axlynrocks/snap/README.md

# snap!

snap is a camera/tracker thing designed for logging your adventures! (readme still in progress)
