axlynrocks/snap/components/DF12NB(3.0)-36DP-0.5V(51).stp

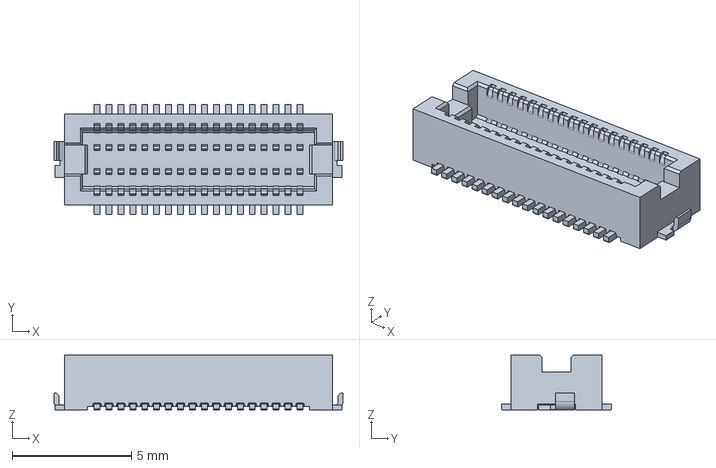
[picture p6: CAD file, 2026-09-12]
components/DF12NB(3.0)-36DP-0.5V(51).stp
12.1 x 4.60 x 2.30 mm
