axlynrocks/snap/components/DF12NB(3.0)-36DS-0.5V(51).stp

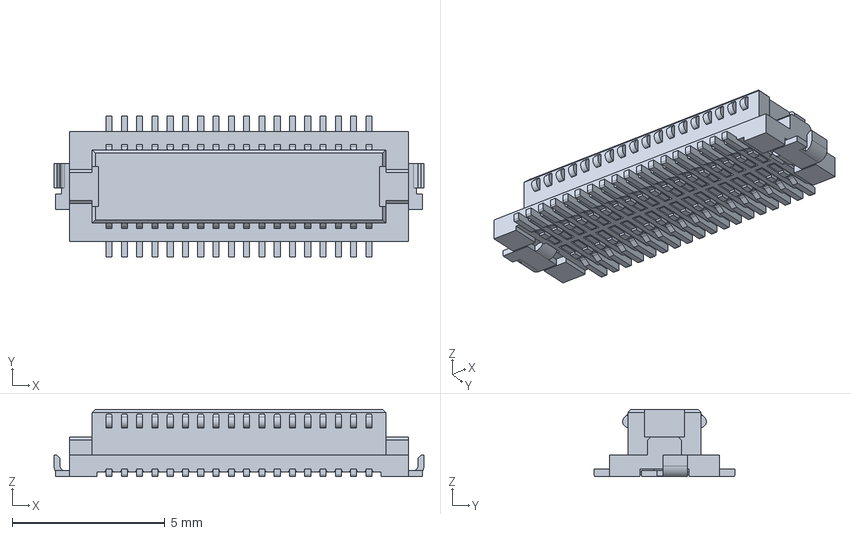
[picture p7: CAD file, 2026-09-12]
components/DF12NB(3.0)-36DS-0.5V(51).stp
12.1 x 4.60 x 2.20 mm
