axlynrocks/snap/components/BG95.step

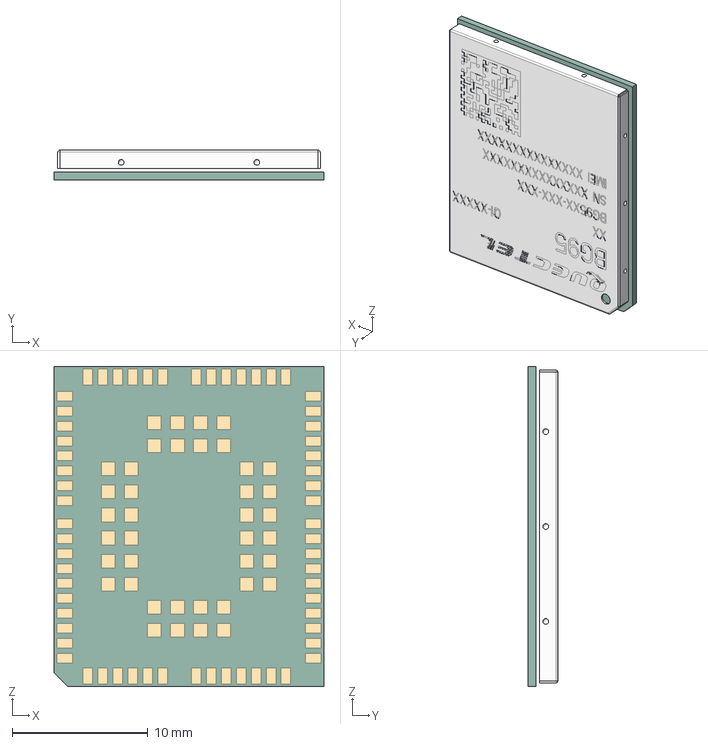
[picture p8: CAD file, 2026-09-10]
components/BG95.step
19.9 x 2.20 x 23.6 mm
BG95_COVER
BG95_PCB
