axlynrocks/snap/components/EG912U-GL.step

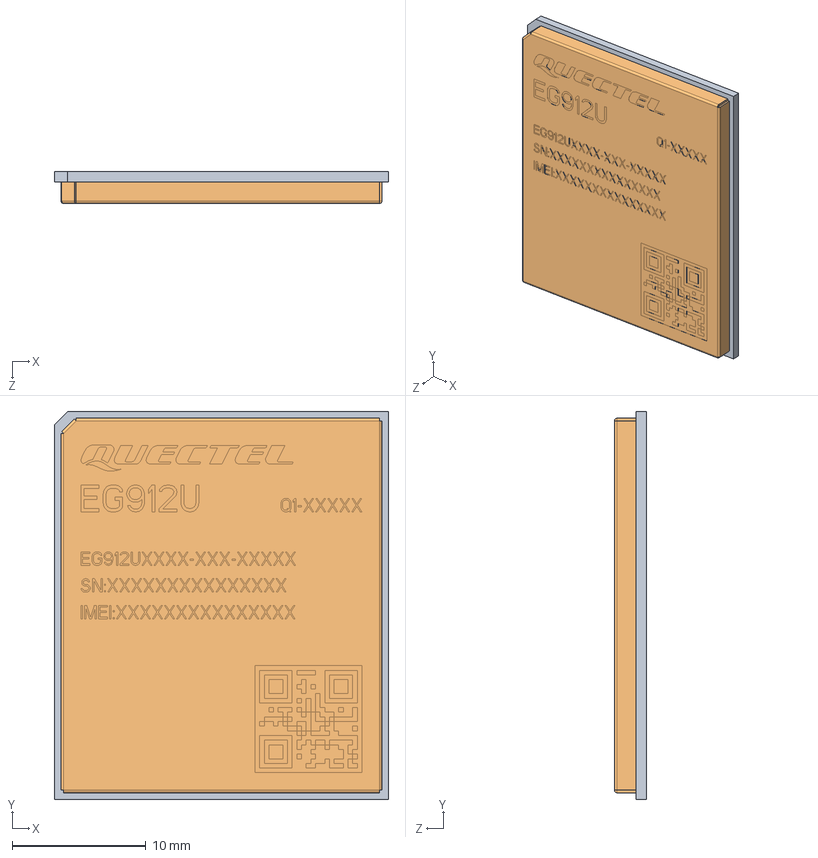
[picture p9: CAD file, 2026-09-01]
components/EG912U-GL.step
25.0 x 29.0 x 2.40 mm
EG912N-EN_PCB.stp
EG912N-EU.stp
