axlynrocks/snap/snap.ioc

Mcu.UserName=STM32H7B3VITx
PA0.GPIO_Label=T_TX
PA0.Signal=UART4_TX
PA1.Signal=OCTOSPIM_P1_IO3
PA10.GPIO_Label=RGB_LED_B
PA10.Signal=GPIO_Output
PA11.GPIO_Label=MIC_WS
PA11.Signal=I2S2_WS
PA12.GPIO_Label=MIC_CK
PA12.Signal=I2S2_CK
PA13.GPIO_Label=T_SWDIO
PA13.Signal=DEBUG_JTMS-SWDIO
PA14.GPIO_Label=T_SWCLK
PA14.Signal=DEBUG_JTCK-SWCLK
PA15.GPIO_Label=T_JTDI
PA15.Signal=DEBUG_JTDI
PA3.Signal=OCTOSPIM_P1_CLK
PA4.Signal=DCMI_HSYNC
PA6.Signal=DCMI_PIXCLK
PA7.Signal=OCTOSPIM_P1_IO2
PA8.GPIO_Label=RGB_LED_R
PA8.Signal=GPIO_Output
PA9.GPIO_Label=RGB_LED_G
PA9.Signal=GPIO_Output
PB0.Signal=OCTOSPIM_P1_IO1
PB10.Signal=OCTOSPIM_P1_NCS
PB12.GPIO_Label=RF_S_RX
PB12.Signal=UART5_RX
PB13.GPIO_Label=RF_S_TX
PB13.Signal=UART5_TX
PB3.GPIO_Label=T_SWO
PB3.Signal=DEBUG_JTDO-SWO
PB4.GPIO_Label=T_NRST
PB4.Signal=DEBUG_NJTRST
PB6.GPIO_Label=DCMI_SCL
PB6.Signal=I2C1_SCL
PB7.Signal=DCMI_VSYNC
PB9.GPIO_Label=DCMI_SDA
PB9.Signal=I2C1_SDA
PC10.Signal=SDMMC1_D2
PC11.Signal=SDMMC1_D3
PC12.Signal=SDMMC1_CK
PC14-OSC32_IN.Signal=RCC_OSC32_IN
PC15-OSC32_OUT.Signal=RCC_OSC32_OUT
PC2_C.GPIO_Label=MIC_SDI
PC2_C.Signal=I2S2_SDI
PC3_C.Signal=OCTOSPIM_P1_IO0
PC6.Signal=DCMI_D0
PC7.Signal=DCMI_D1
PC8.Signal=SDMMC1_D0
PC9.Signal=SDMMC1_D1
PD0.GPIO_Label=T_RX
PD0.Signal=UART4_RX
PD10.GPIO_Label=RF_GPIO_08
PD10.Signal=GPIO_Output
PD11.GPIO_Label=RF_GPIO_06
PD11.Signal=GPIO_Output
PD12.GPIO_Label=RF_GPIO_04
PD12.Signal=GPIO_Output
PD13.GPIO_Label=RF_GPIO_03
PD13.Signal=GPIO_Output
PD14.GPIO_Label=RF_GPIO_02
PD14.Signal=GPIO_Input
PD15.GPIO_Label=RF_GPIO_01
PD15.Signal=GPIO_Output
PD2.Signal=SDMMC1_CMD
PD3.Signal=DCMI_D5
PD4.GPIO_Label=DCMI_RST
PD4.Signal=GPIO_Output
PD5.GPIO_Label=DCMI_FSIN
PD5.Signal=GPIO_Output
PD6.GPIO_Label=DCMI_PWDN
PD6.Signal=GPIO_Output
PD8.GPIO_Label=RF_GPIO_10
PD8.Signal=GPIO_Output
PD9.GPIO_Label=RF_GPIO_09
PD9.Signal=GPIO_Output
PE0.Signal=DCMI_D2
PE1.Signal=DCMI_D3
PE10.GPIO_Label=RF_CTS
PE10.Signal=UART7_CTS
PE11.GPIO_Label=DCMI_NSS
PE11.Signal=SPI4_NSS
PE13.GPIO_Label=DCMI_MISO
PE13.Signal=SPI4_MISO
PE14.GPIO_Label=DCMI_MOSI
PE14.Signal=SPI4_MOSI
PE2.GPIO_Label=DCMI_SCK
PE2.Signal=SPI4_SCK
PE4.Signal=DCMI_D4
PE5.Signal=DCMI_D6
PE6.Signal=DCMI_D7
PE7.GPIO_Label=RF_RXD
PE7.Signal=UART7_RX
PE8.GPIO_Label=RF_TXD
PE8.Signal=UART7_TX
PE9.GPIO_Label=RF_RTS
PE9.Signal=UART7_RTS
PH0-OSC_IN.Signal=RCC_OSC_IN
PH1-OSC_OUT.Signal=RCC_OSC_OUT
