axlynrocks/snap/(commit log)

2026-08-21 added necessary files
    [snap.kicad_pcb, snap.kicad_sch]
2026-08-22 updated JOURNAL.md
    [snap.kicad_sch]
2026-08-23 added MCU ECAD models
    [LQFP64_STM.step]
2026-08-23 fixed symbol and footprint library paths
2026-08-23 fixed footprint library path
2026-08-23 added oscillator ECAD models
    [ECS-80-18-23B-JTN-TR.step, XTAL_SC32S-7PF20PPM_EPS.step]
2026-08-23 worked on the schematics pt.1 and researched
    [snap.kicad_sch]
2026-08-29 researched cameras and stuff
2026-08-31 removed the STM32U3C5RIT6 ECAD models
    [LQFP64_STM.step]
2026-08-31 fixed BOM and researched new MCU
2026-09-01 removed donwloaded ECAD models
    [ECS-80-18-23B-JTN-TR.step, XTAL_SC32S-7PF20PPM_EPS.step]
2026-09-01 removed outdated schematics
    [snap.kicad_sch]
2026-09-01 added EG912U-GL ECAD models to components
    [EG912U-GL.step]
2026-09-01 added antenna ECAD models to components
2026-09-01 added microphone ECAD schematic to components
2026-09-02 added microphone ECAD footprint to components
2026-09-02 added oscillator ECAD footprints to components
2026-09-02 added debug connector ECAD footprint to components
2026-09-03 actually starting to do the schematics with all these new parts
2026-09-03 added decoupling capacitors to schematic
    [snap.kicad_sch]
2026-09-03 actually starting to do the schematics pt.2
2026-09-04 actually starting to do the schematics pt.3
    [snap.kicad_sch]
2026-09-05 added button ECAD footprint to components and updated library link
2026-09-05 actually starting to do the schematics pt.4
    [snap.kicad_sch]
2026-09-06 actually starting to do the schematics pt.5
    [snap.kicad_sch]
2026-09-07 actually starting to do the schematics pt.6
    [MCU_peripherals.kicad_sch, MCU_power.kicad_sch, STLINK_connector.kicad_sch, snap.kicad_sch]
2026-09-09 small schematic hiatus
2026-09-10 added cellular module ECAD models to components
    [BG95.step]
2026-09-10 actually starting to do the schematics pt.7
    [comms.kicad_sch, snap.kicad_sch]
2026-09-11 deciding on which pins to breakout and making a BOM
2026-09-11 time to lock in for the schematic!!!
    [snap.kicad_sch]
2026-09-12 time to lock in for the schematic!!! (continued)
    [DF12NB(3.0)-36DP-0.5V(51).stp, DF12NB(3.0)-36DS-0.5V(51).stp, snap.kicad_sch]
2026-09-16 time to lock in for the schematic (continued pt.3)
    [snap.kicad_sch]
2026-09-17 i'm running out of update messages
    [rf.kicad_sch, snap.kicad_sch]
